wilsonjosephdaniel-design/RFID/docs/controls/png/1_dock_door_concept.png

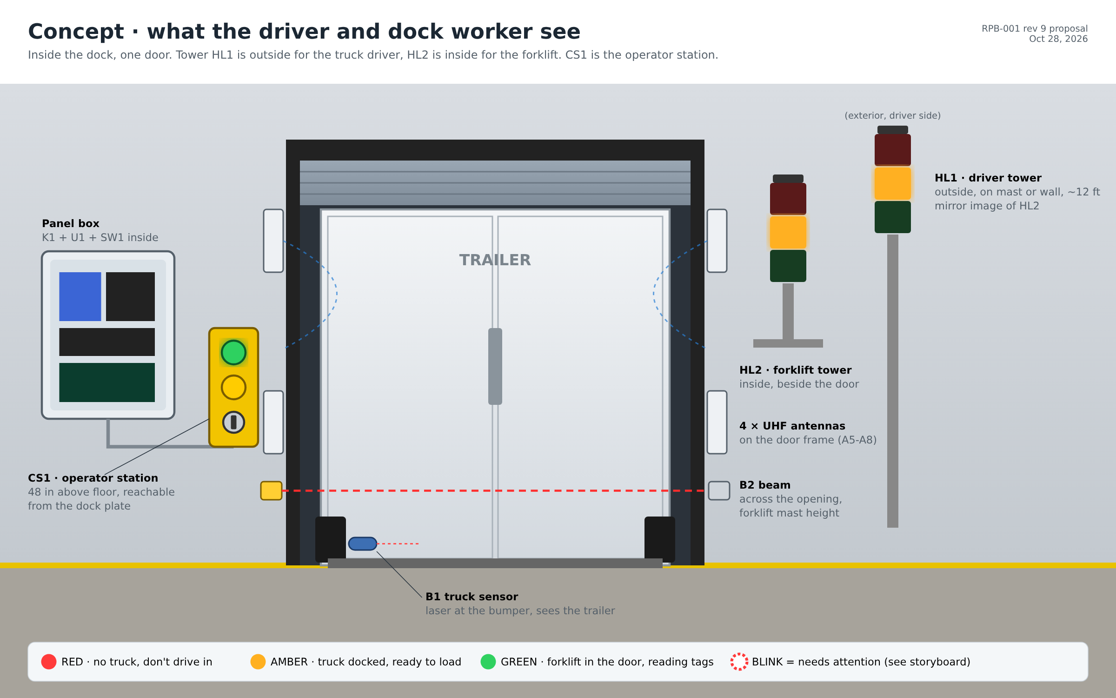
docs/controls/png/1_dock_door_concept.png
