wilsonjosephdaniel-design/RFID/docs/controls/controls_concept.html

# Concept · what the driver and dock worker see

Inside the dock, one door. Tower HL1 is outside for the truck driver, HL2 is inside for the forklift. CS1 is the operator station.

RPB-001 rev 9 proposal
Oct 28, 2026

# CS1 · three-button operator station

22 mm IP65 parts in a 3-hole yellow box. Wired to K1 DI3-DI5 and CH5 (sheet W3 / W2). Every button is only a request: the C# service decides.

RPB-001 rev 9 proposal
Oct 28, 2026

# Storyboard · one trailer, start to finish

What the towers, buzzer and S1 lamp do. Logic runs in the C# service; the box only shows what it's told (MQTT_CONTRACT.md).

RPB-001 rev 9 proposal
Oct 28, 2026

# Dashboard · ASP.NET Core + SignalR page on the C# service

Live door tiles mirror each box over MQTT. Supervisor controls are server-side commands, logged with who and when.

mockup · not live data

MERP RFID · Dock doorsBroker ● onlineService ● online8 doors · 1 fault · 1 maintShift 2 · 14:32

Loads this shift

Door | Trailer | Order | Tags / expected | Closed | Result
01 | TRL 5517 | SO 88407 | 52 / 52 | 14:28 | ✓ posted to MERP
05 | TRL 5519 | SO 88410 | 17 / 40 | — | open · 1 wrong-load ACKed
02 | TRL 5508 | SO 88399 | 36 / 36 | 13:47 | ✓ posted to MERP
04 | TRL 5502 | SO 88391 | 48 / 50 | 13:05 | 2 short · supervisor closed

#### Door 03 · selected

StateGREEN · reading

Trailer / orderTRL 5521 · SO 88412

Tags this load38 / 44 pallets

Truck (DI1) · Beam (DI2)1 · 1

Box fw · IP · uptime1.1.0 · 10.0.0.43 · 6 d

MAC58:CF:79:xx:xx:43

Force RED Silence Maint

Close load Re-open Test lamps

#### Events

14:31:58 Door 03 beam broken → GREEN

14:31:40 Door 06 box offline (LWT) → shown FAULT

14:30:12 Door 05 wrong-load tag 3034…A91 → RED blink, buzzer

14:30:20 Door 05 S2 ACK pressed (buzzer off)

14:28:03 Door 01 S1 LOAD COMPLETE · 52/52 tags ✓

14:20:45 Door 07 S3 MAINT key ON (J. Ortiz)

14:12:09 Door 02 truck arrived → AMBER, chirp
