wilsonjosephdaniel-design/RFID/docs/controls/png/2_operator_station_CS1.png

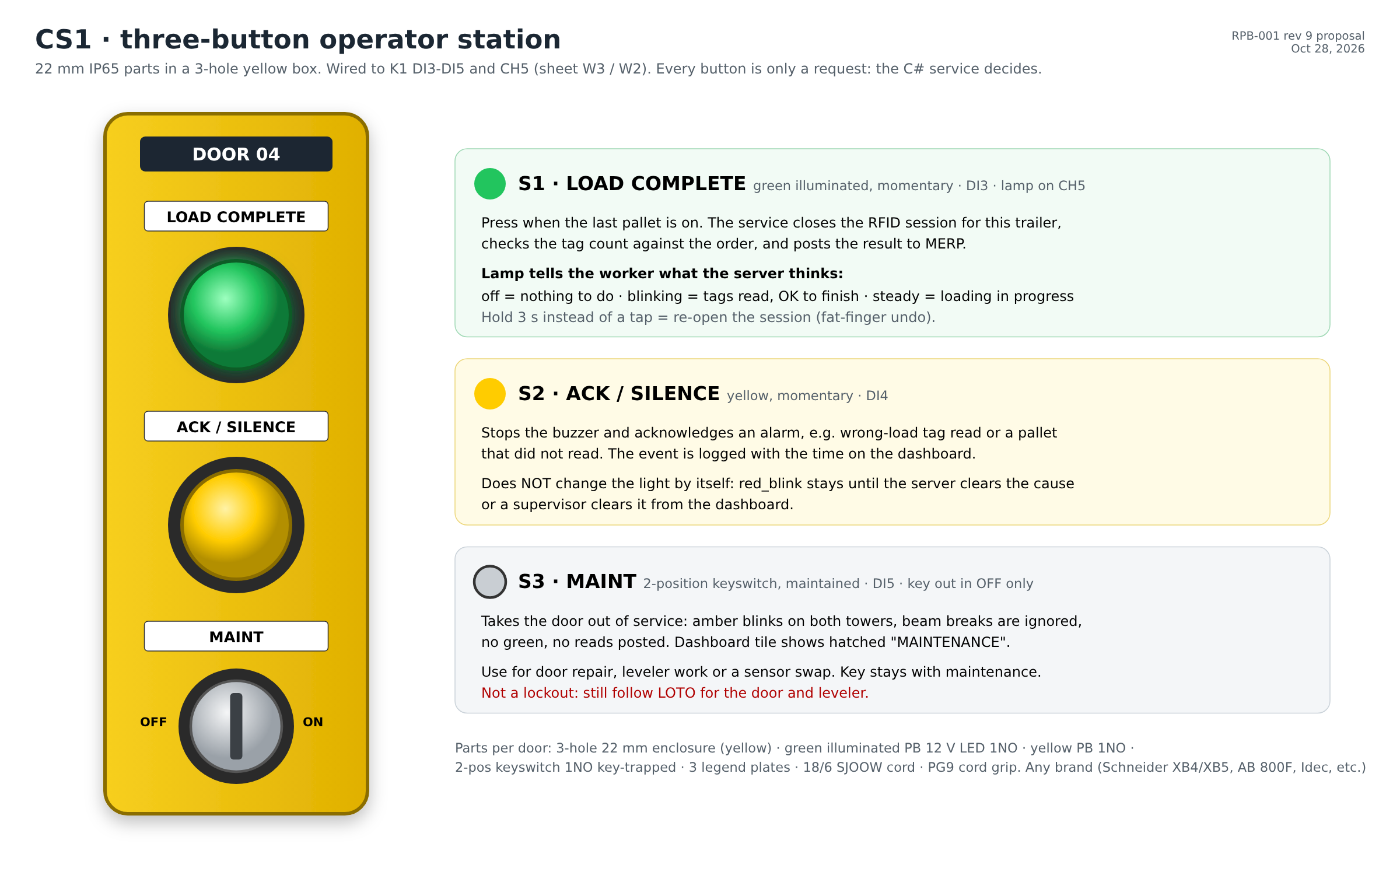
docs/controls/png/2_operator_station_CS1.png
