wilsonjosephdaniel-design/RFID/docs/controls/png/3_light_storyboard.png

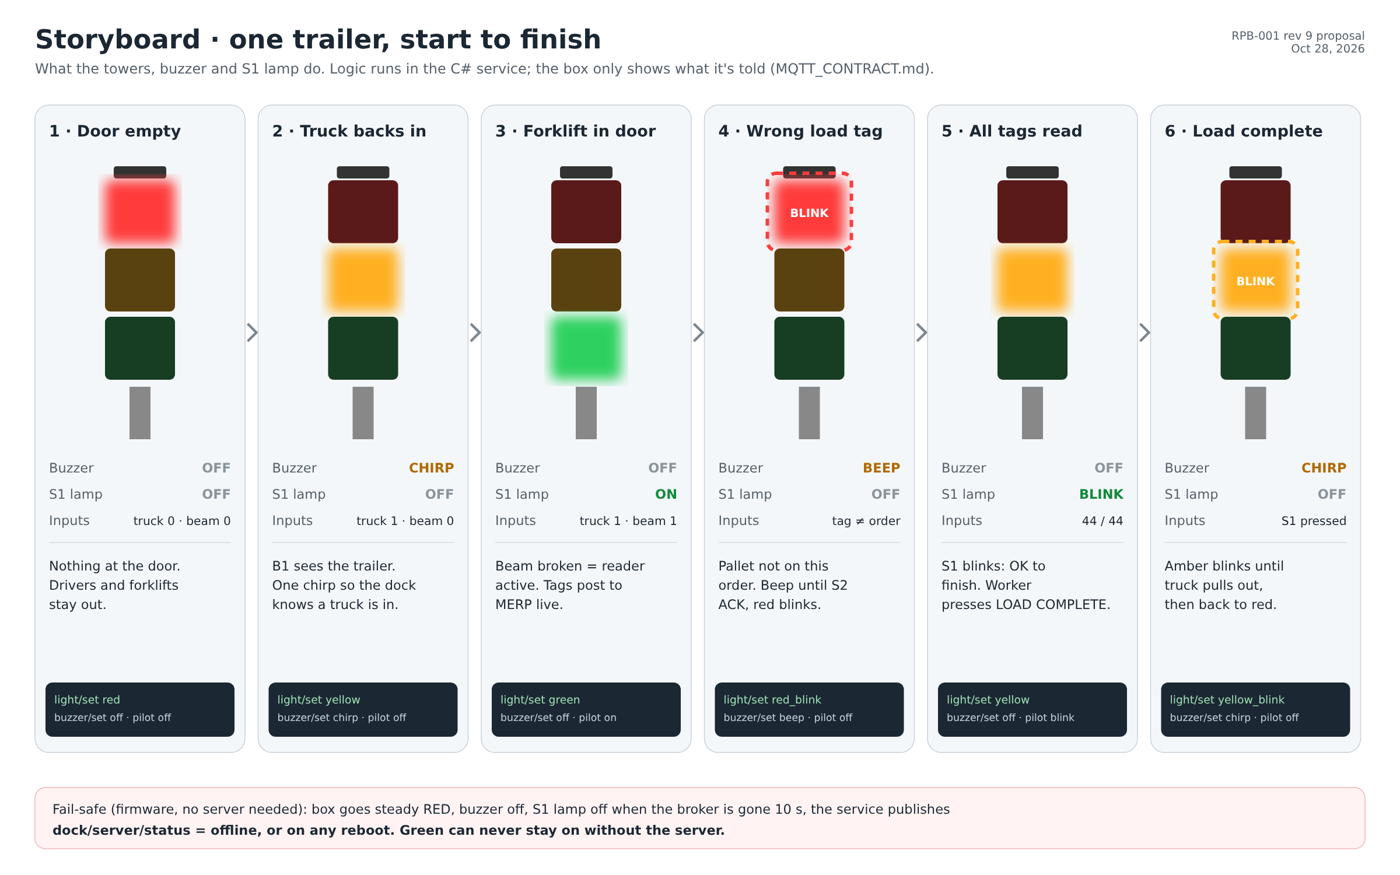
docs/controls/png/3_light_storyboard.png
