wilsonjosephdaniel-design/RFID/docs/controls/png/4_dashboard_mockup.png

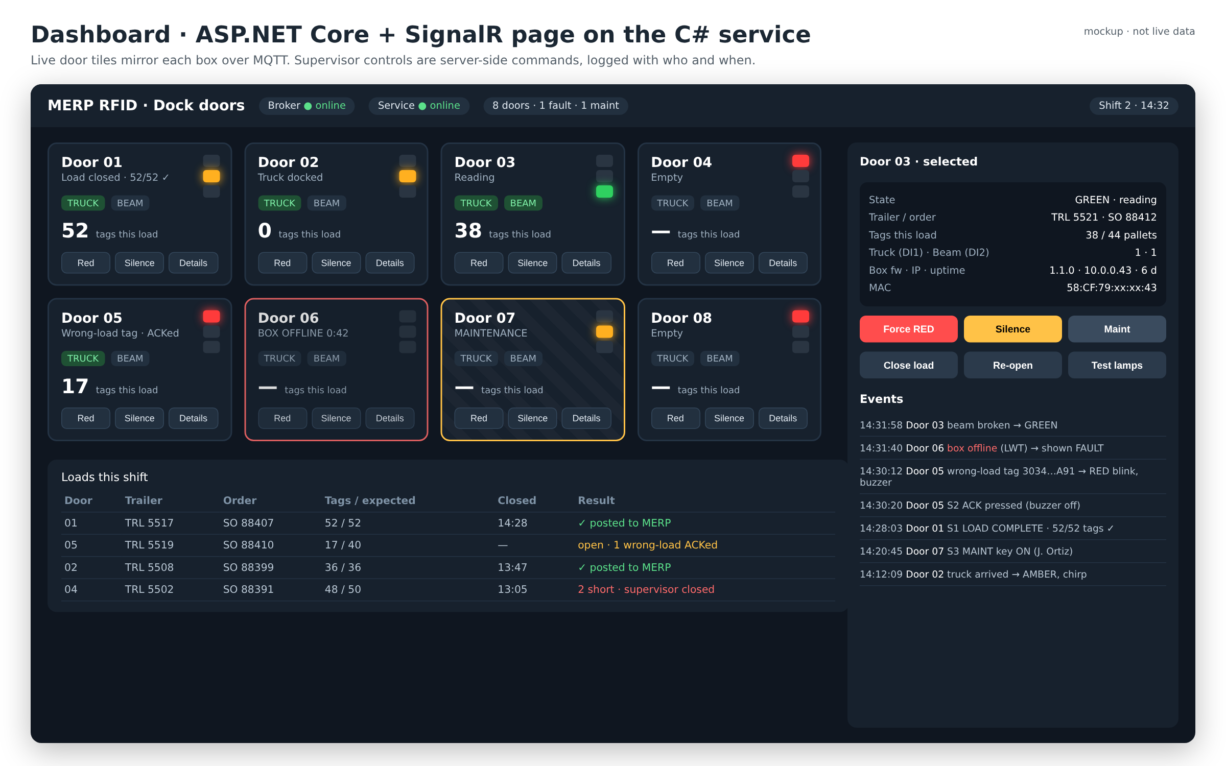
docs/controls/png/4_dashboard_mockup.png
