wilsonjosephdaniel-design/RFID/docs/schematic/RFID_Panel_Box_Illustrated_Schematic_rev8.png

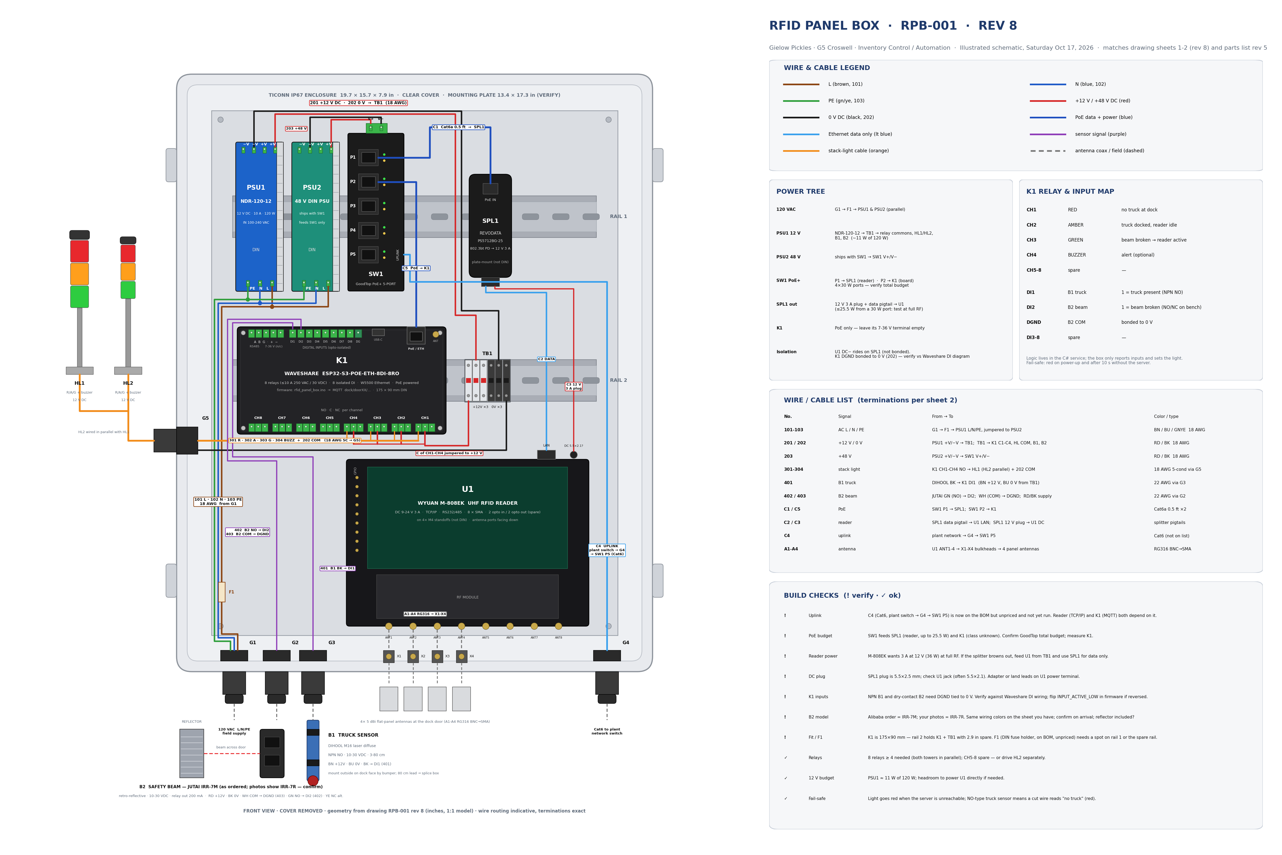
docs/schematic/RFID_Panel_Box_Illustrated_Schematic_rev8.png
