wilsonjosephdaniel-design/RFID/(list of files, cad)

Other CAD files:
docs/drawings/RFID_Panel_Box_RPB-001_rev8.dxf
