wilsonjosephdaniel-design/RFID/docs/wiring/png/W1.png

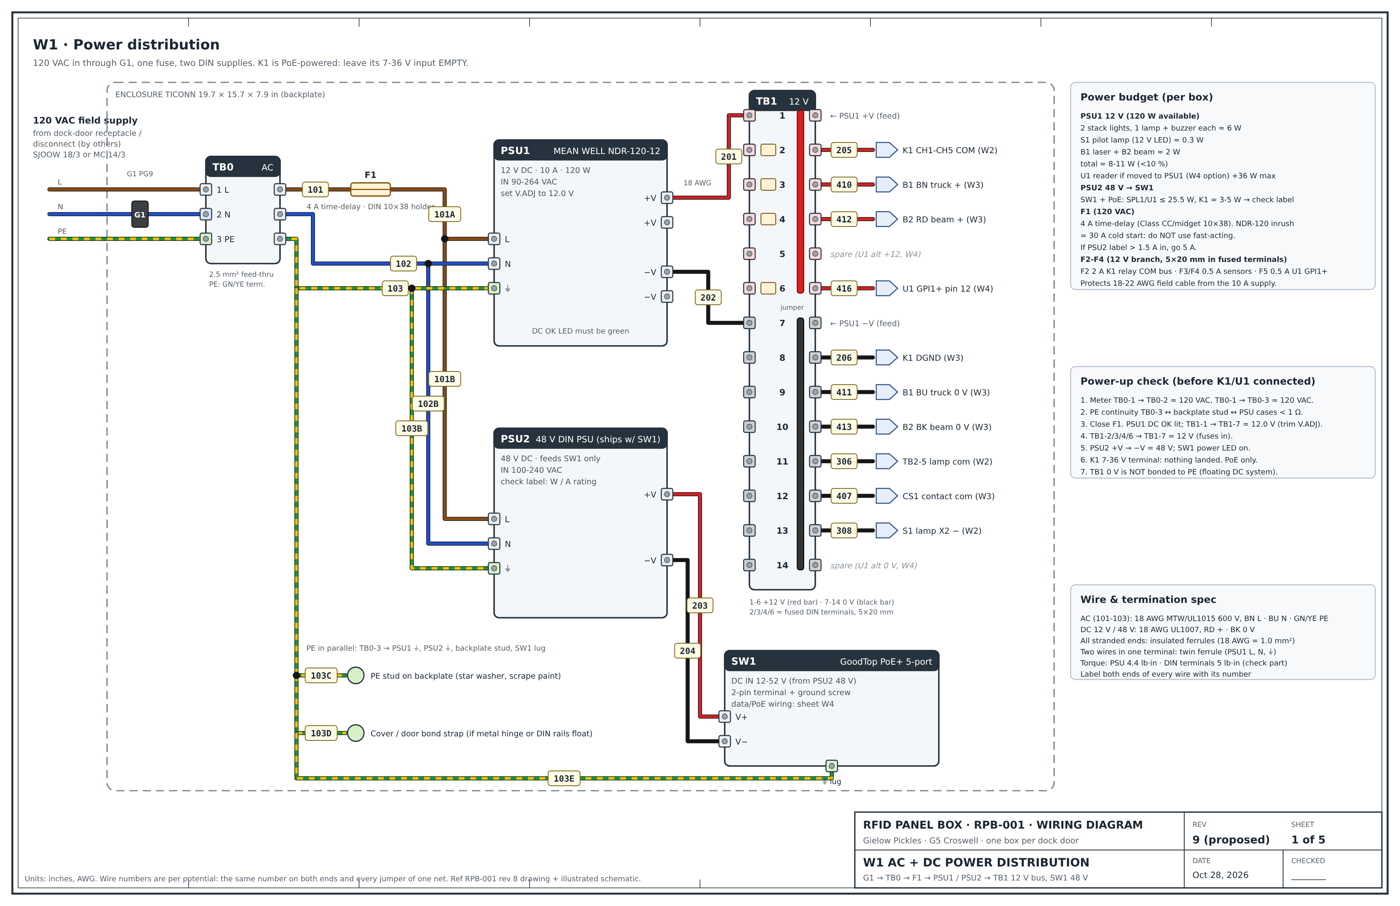
docs/wiring/png/W1.png
