wilsonjosephdaniel-design/RFID/docs/wiring/png/W3.png

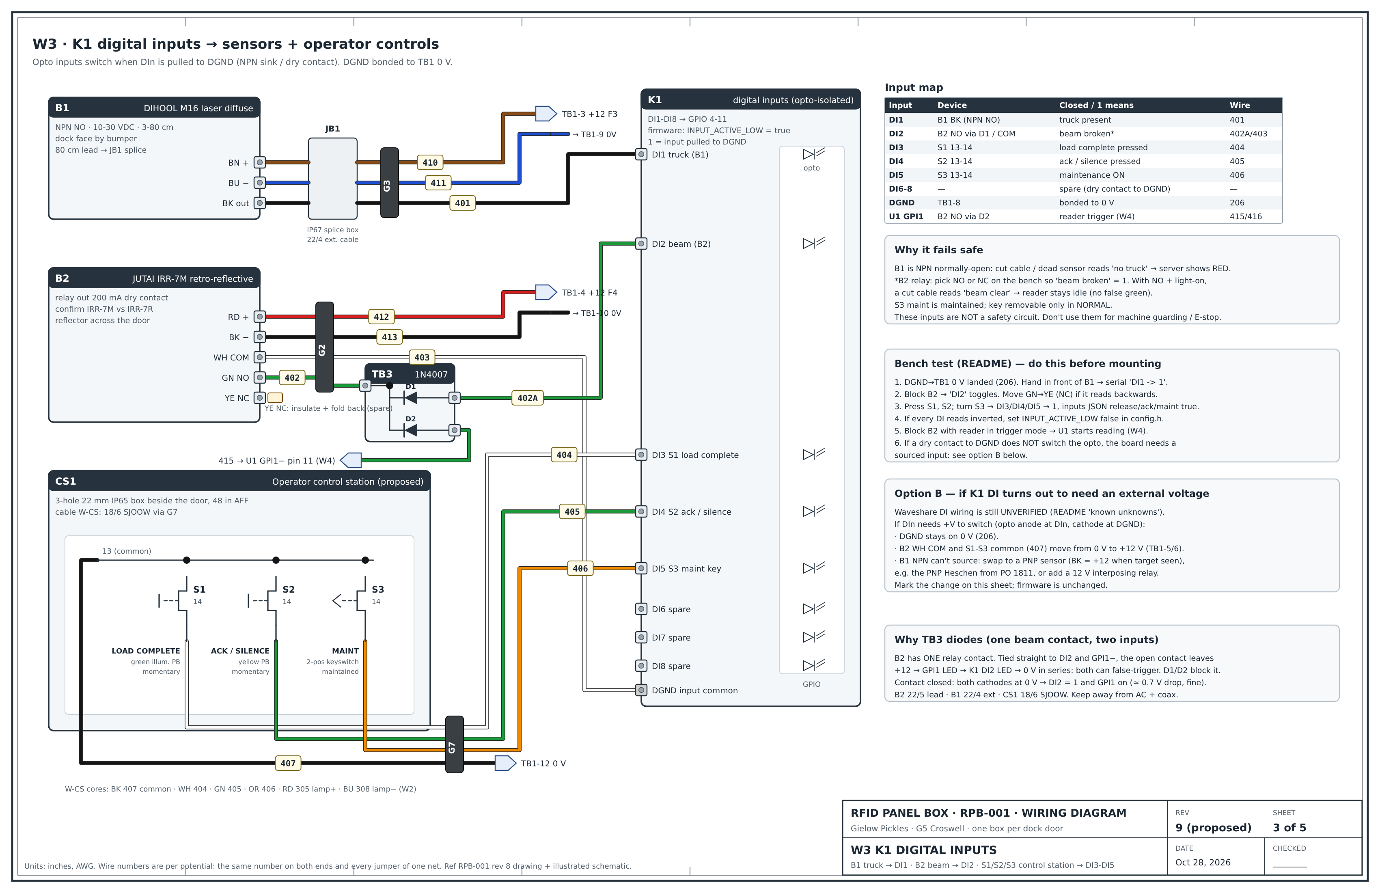
docs/wiring/png/W3.png
