wilsonjosephdaniel-design/RFID/docs/wiring/png/W5.png

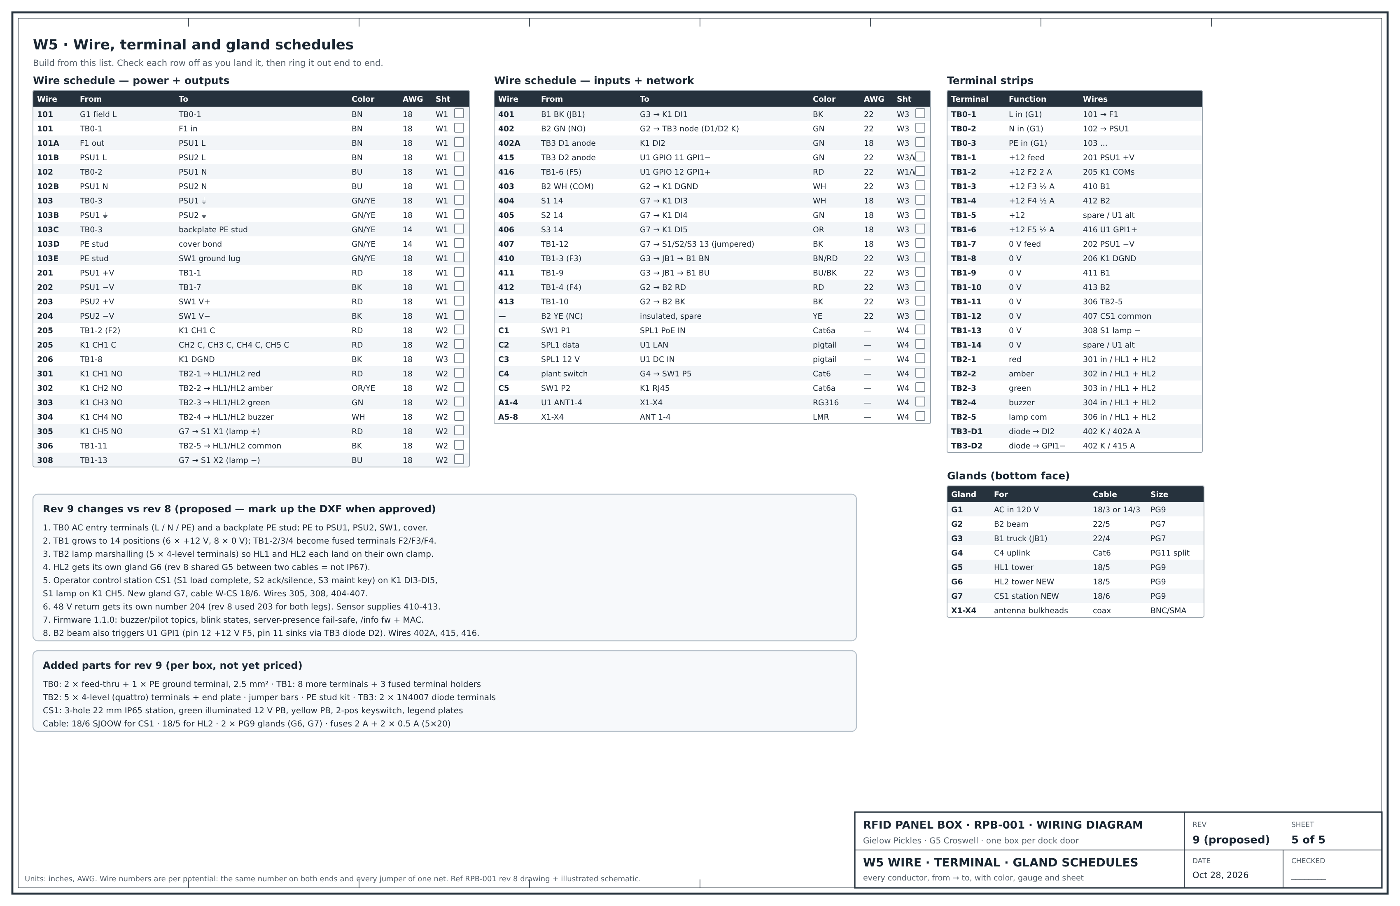
docs/wiring/png/W5.png
