wilsonjosephdaniel-design/RFID/docs/schematic/RFID_Panel_Box_Illustrated_Schematic_rev8.pdf

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

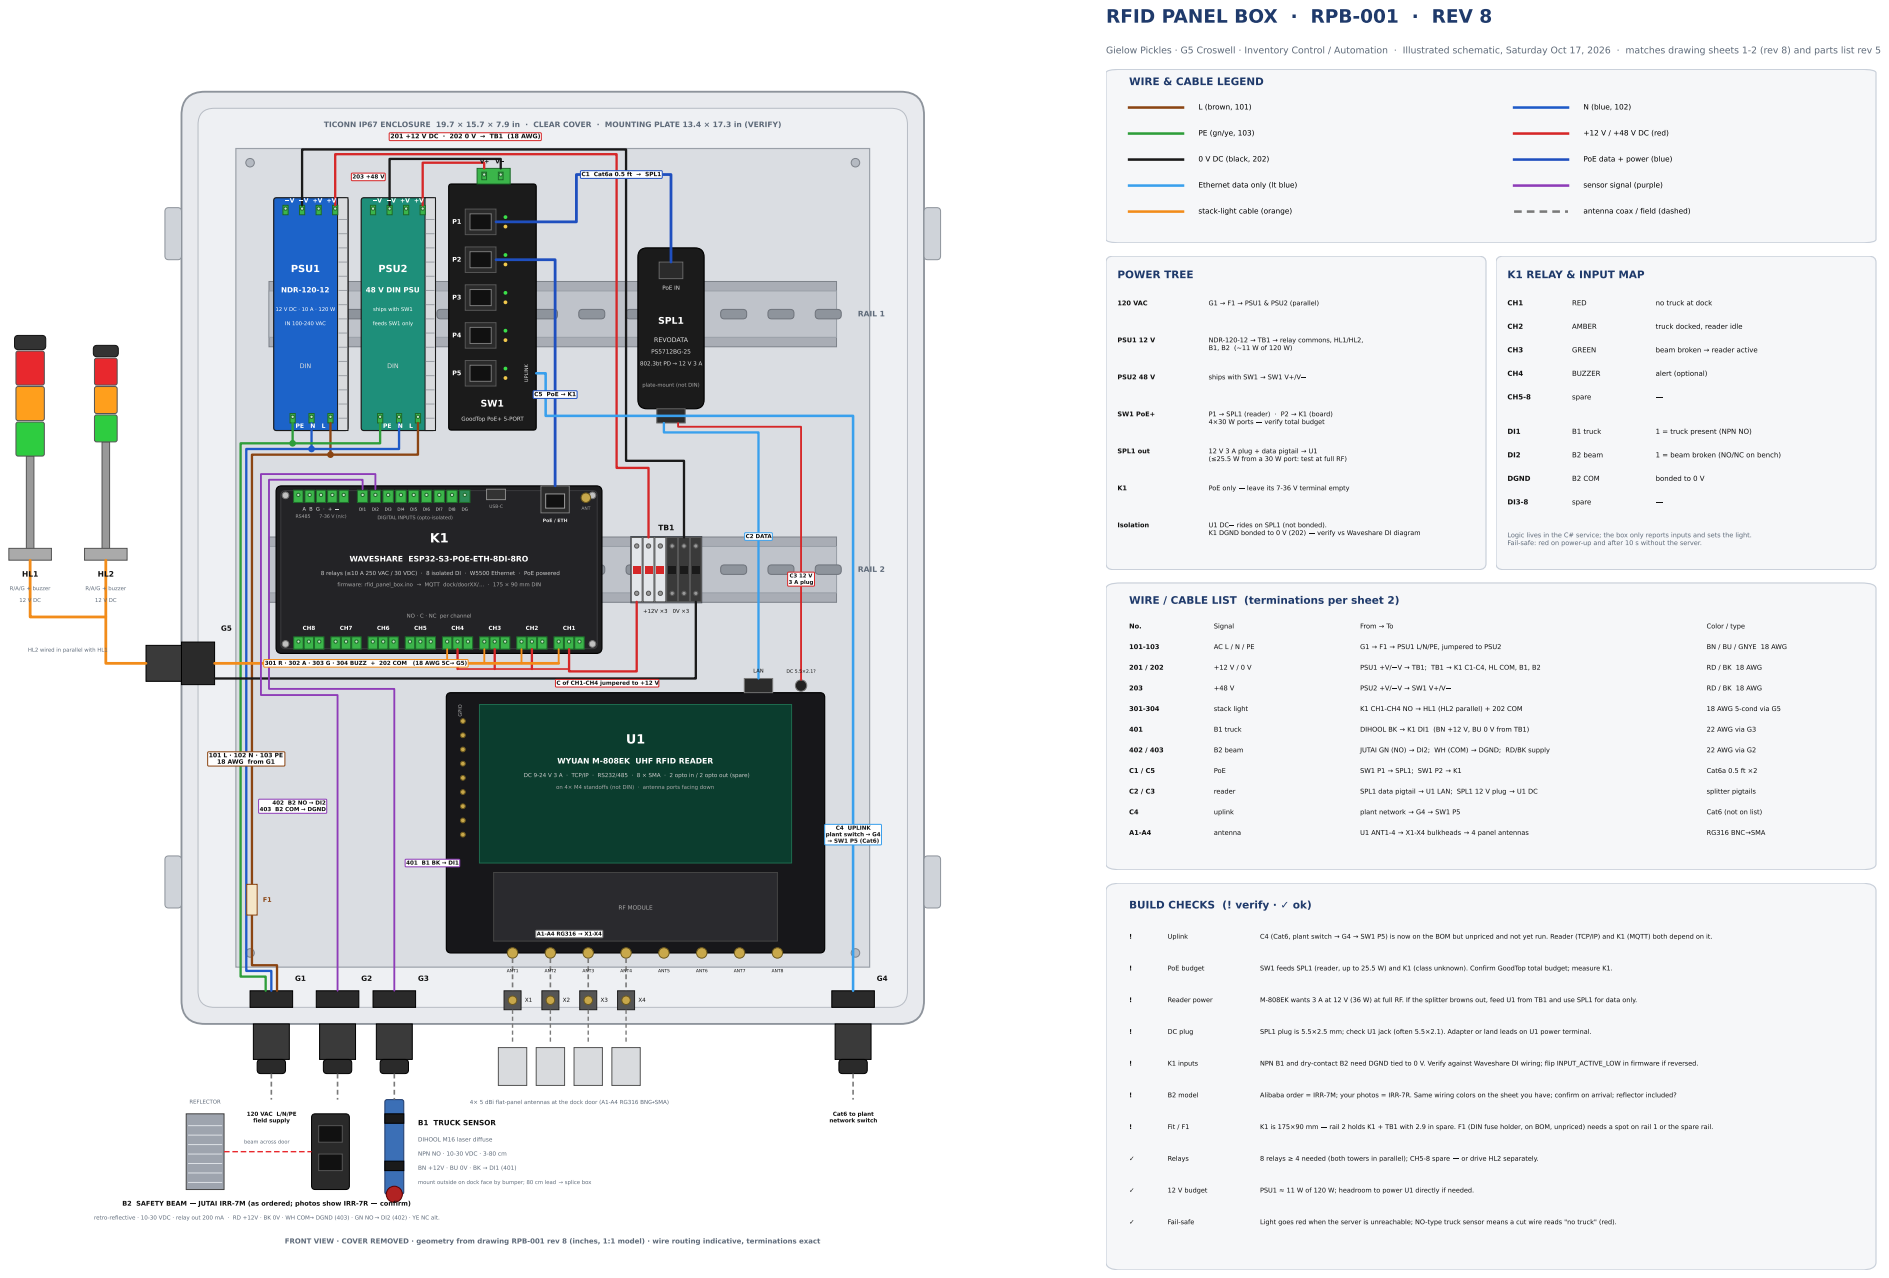
[picture p14: page 1]
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
