wilsonjosephdaniel-design/RFID/docs/drawings/RFID_Panel_Box_RPB-001_rev8.pdf

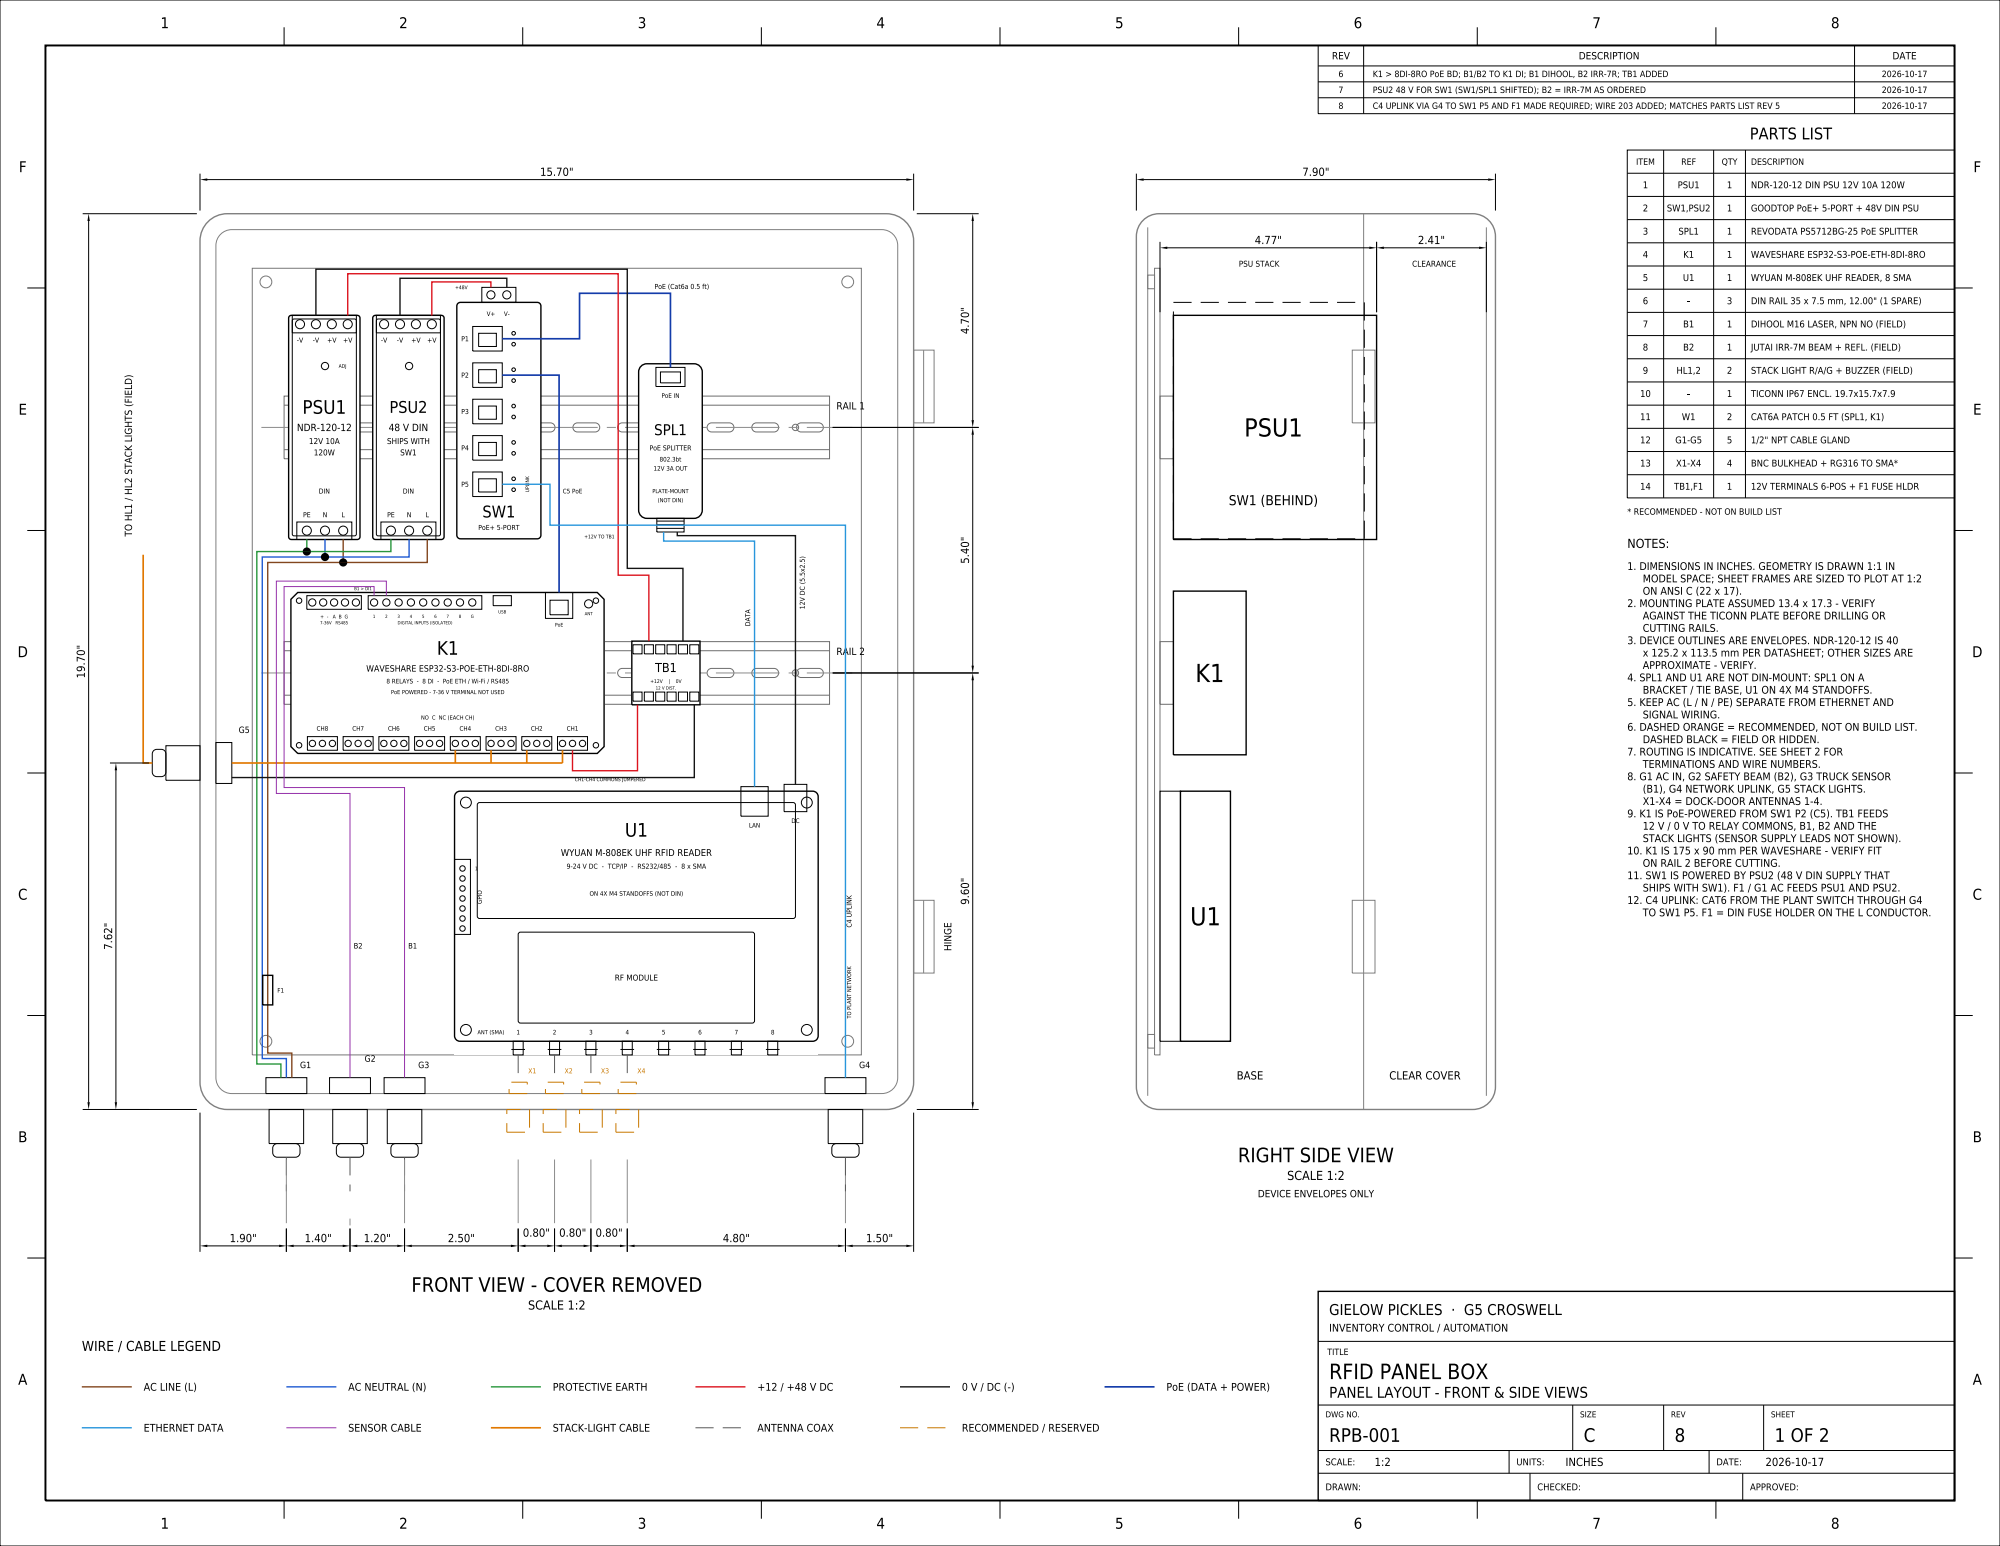
[picture p15: page 1]

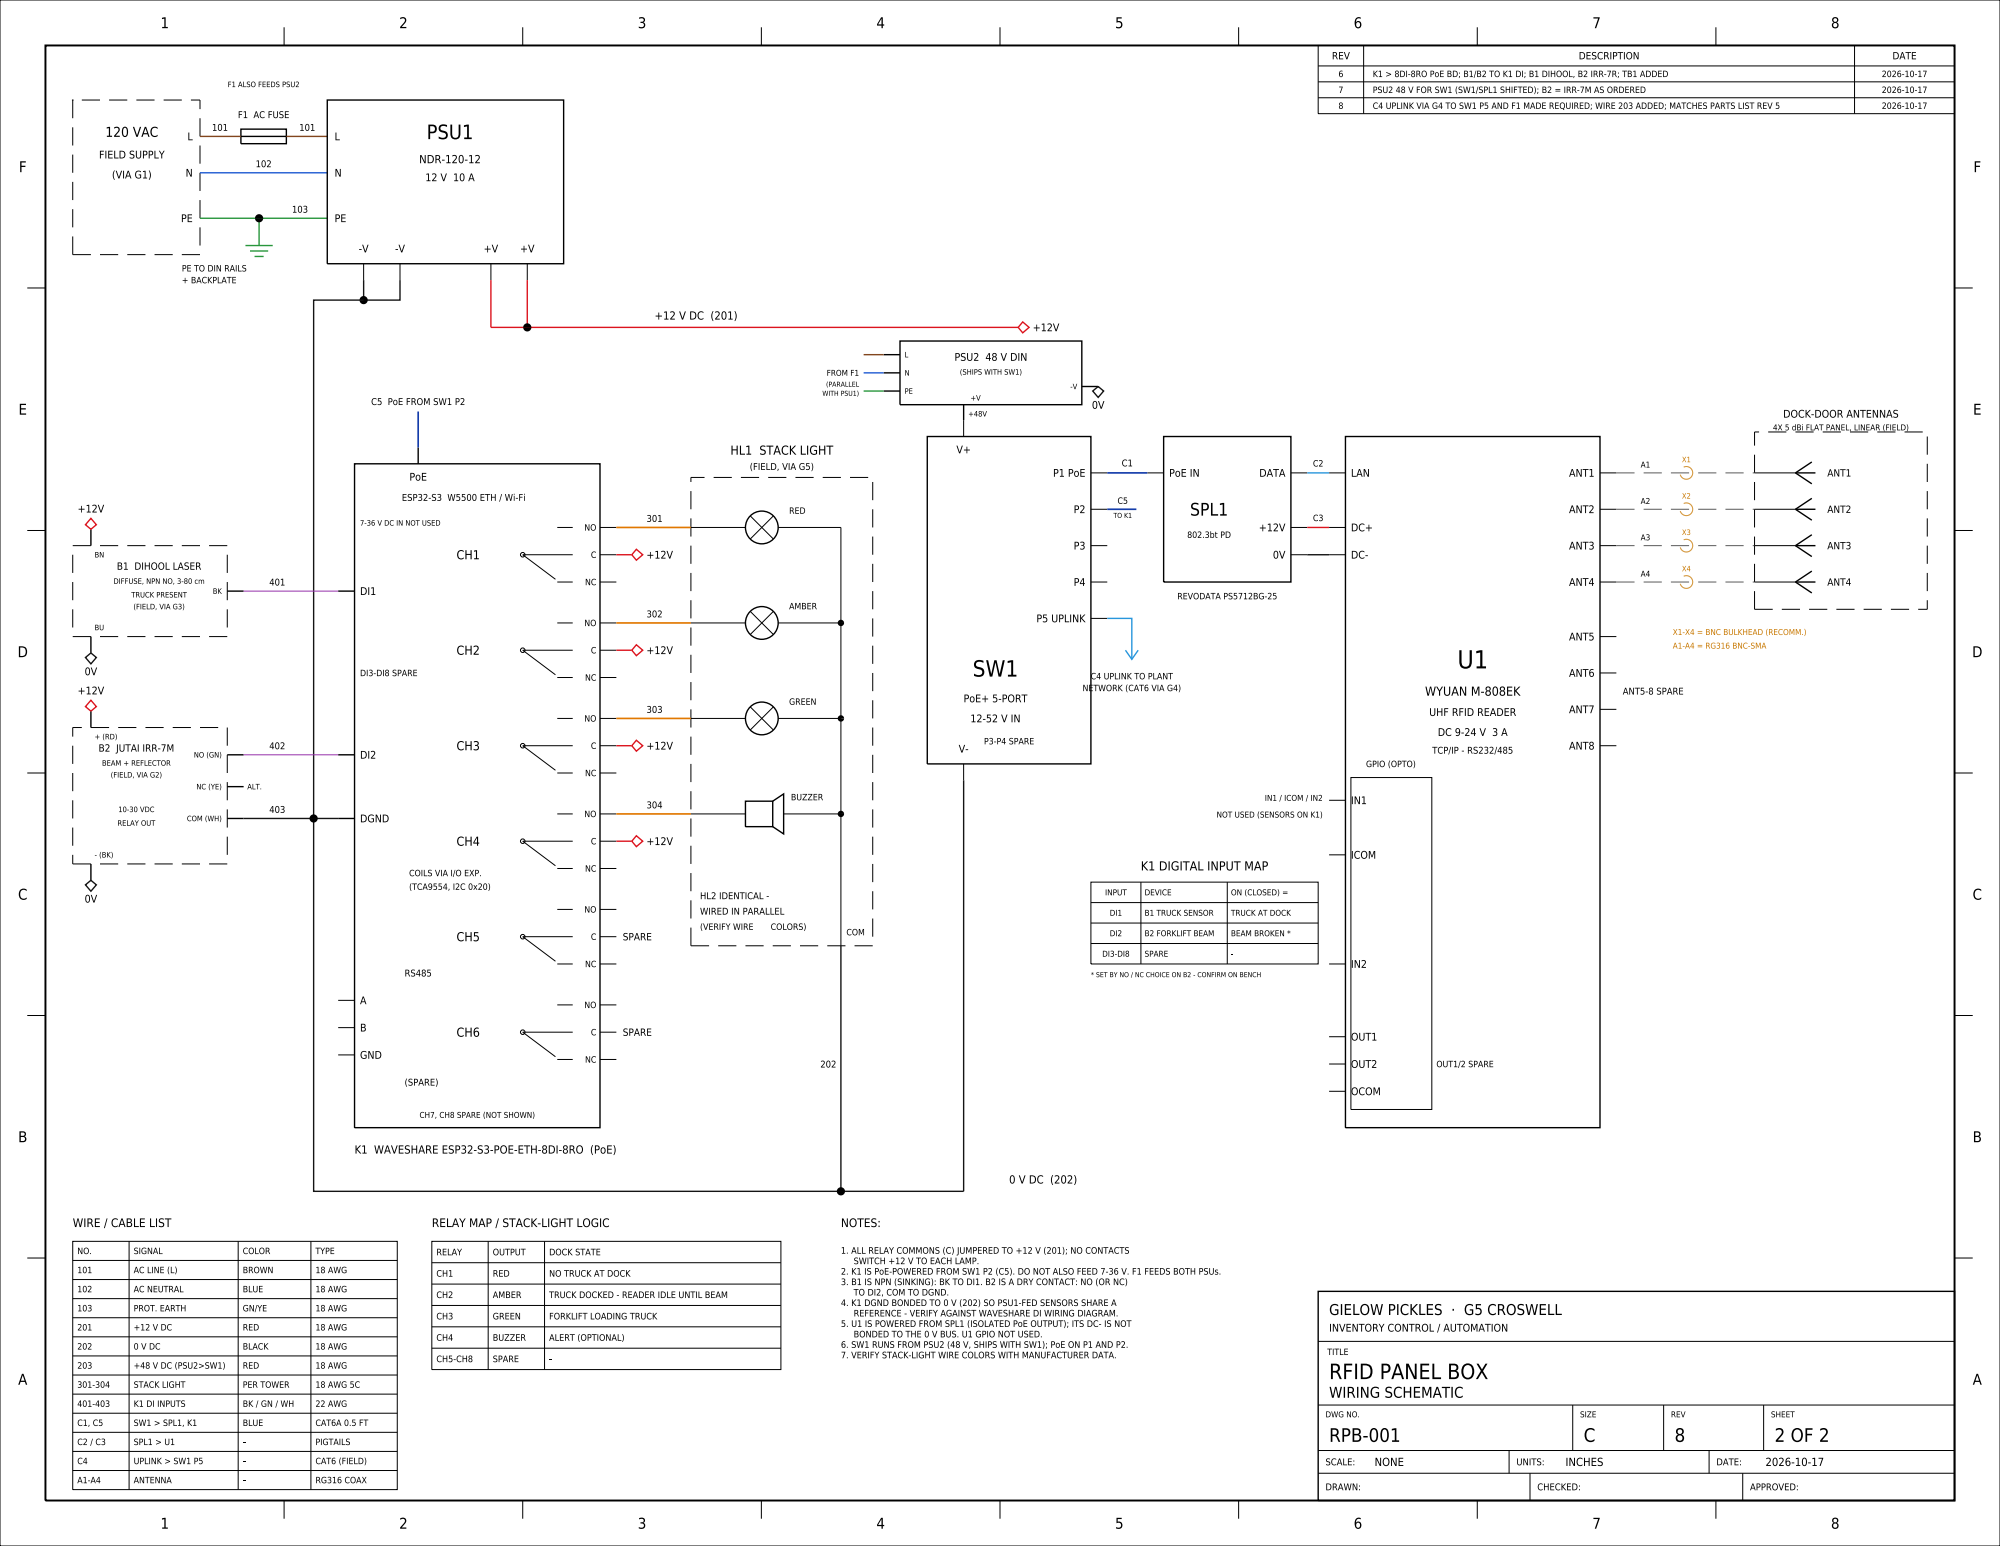
[picture p16: page 2]
