wilsonjosephdaniel-design/RFID/(commit log)

2026-10-28 Add RFID panel box pack, firmware 1.1.0, rev 9 wiring sheets and control concepts
    - Firmware for Waveshare ESP32-S3-POE-ETH-8DI-8RO: per-door config.h, buzzer
    (CH4) and S1 pilot lamp (CH5) topics, blink lights, server-presence fail-safe,
    /info with fw + MAC, watchdog, relay refresh, RGB status LED. Builds on esp32 3.3.12.
    - MQTT contract updated for the new topics and server rules.
    - 5-sheet wiring diagram (power, relay outputs, inputs, network/RF, schedules)
    generated from docs/wiring/generate_wiring.py.
    - Control concept images: dock-door view, CS1 operator station, light
    storyboard, dashboard mockup.
    Claude-Session: https://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
    [RFID_Panel_Box_RPB-001_rev8.dxf]
2026-10-28 Wire reader GPI1 to the forklift beam through a diode split
    U1 GPIO pin 12 (GPI1+) gets constant +12 V from new fused terminal TB1-6 (F5);
    pin 11 (GPI1-) sinks to 0 V when B2 trips. B2's single contact feeds K1 DI2 and
    GPI1- through TB3 diodes D1/D2 to block the sneak path between the two inputs.
    Sheets W1, W3, W4, W5, README, MQTT contract and session notes updated.
    Claude-Session: https://claude.ai/code/session_011z2Qhrs6vmu1RitCRDt5FU
